Eviper01/MAX7000CPU-GEN2.5/Other/logo.dxf

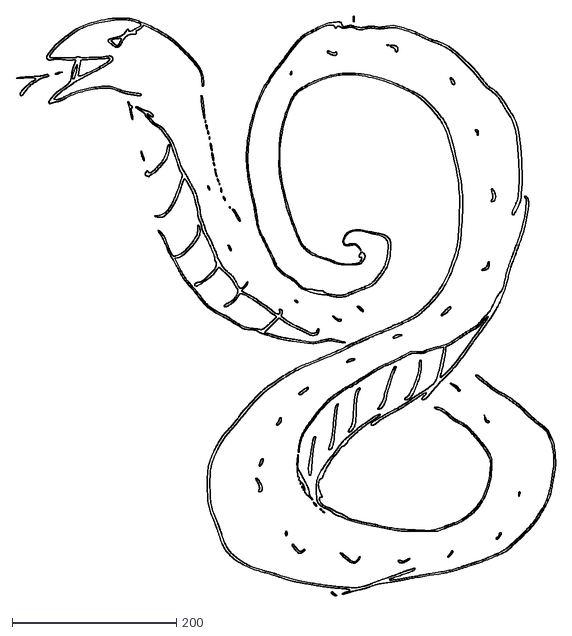
[picture p1: CAD file, 2022-04-16]
Other/logo.dxf
656.7 x 706.0
