Eviper01/MAX7000CPU-GEN2.5/SASM/test.txt

STC &LOOP
LDM RJB
STC 1
LDM R1
STC 2
LDM R2
&LOOP SUM R1 R2
LDM R1
LDM PORTC
SUM R1 R2
LDM R2
LDM PORTC
JMP
