Eviper01/MAX7000CPU-GEN2.5/(list of files, drawings)

Other design files:
KICAD/MAX7000CPU-Gen2_5.dsn
