Eviper01/MAX7000CPU-GEN2.5/KICAD/MAX7000CPU-Gen2_5.kicad_pcb

## KiCad design KICAD/MAX7000CPU-Gen2_5.kicad_pcb (2022-04-16)

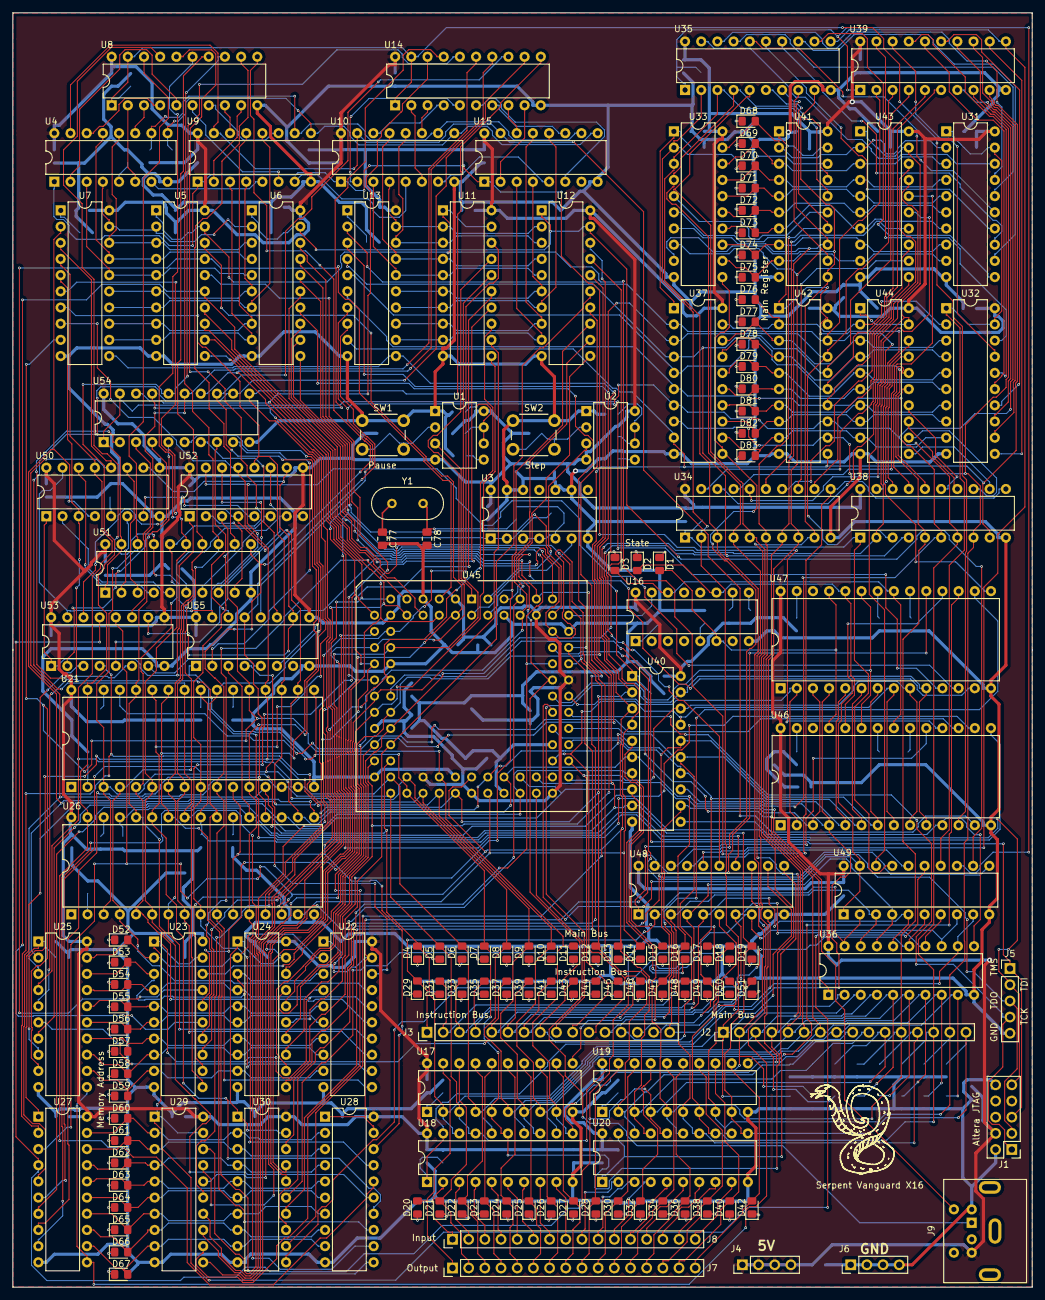
[picture p2: board MAX7000CPU-Gen2_5.kicad_pcb from above]

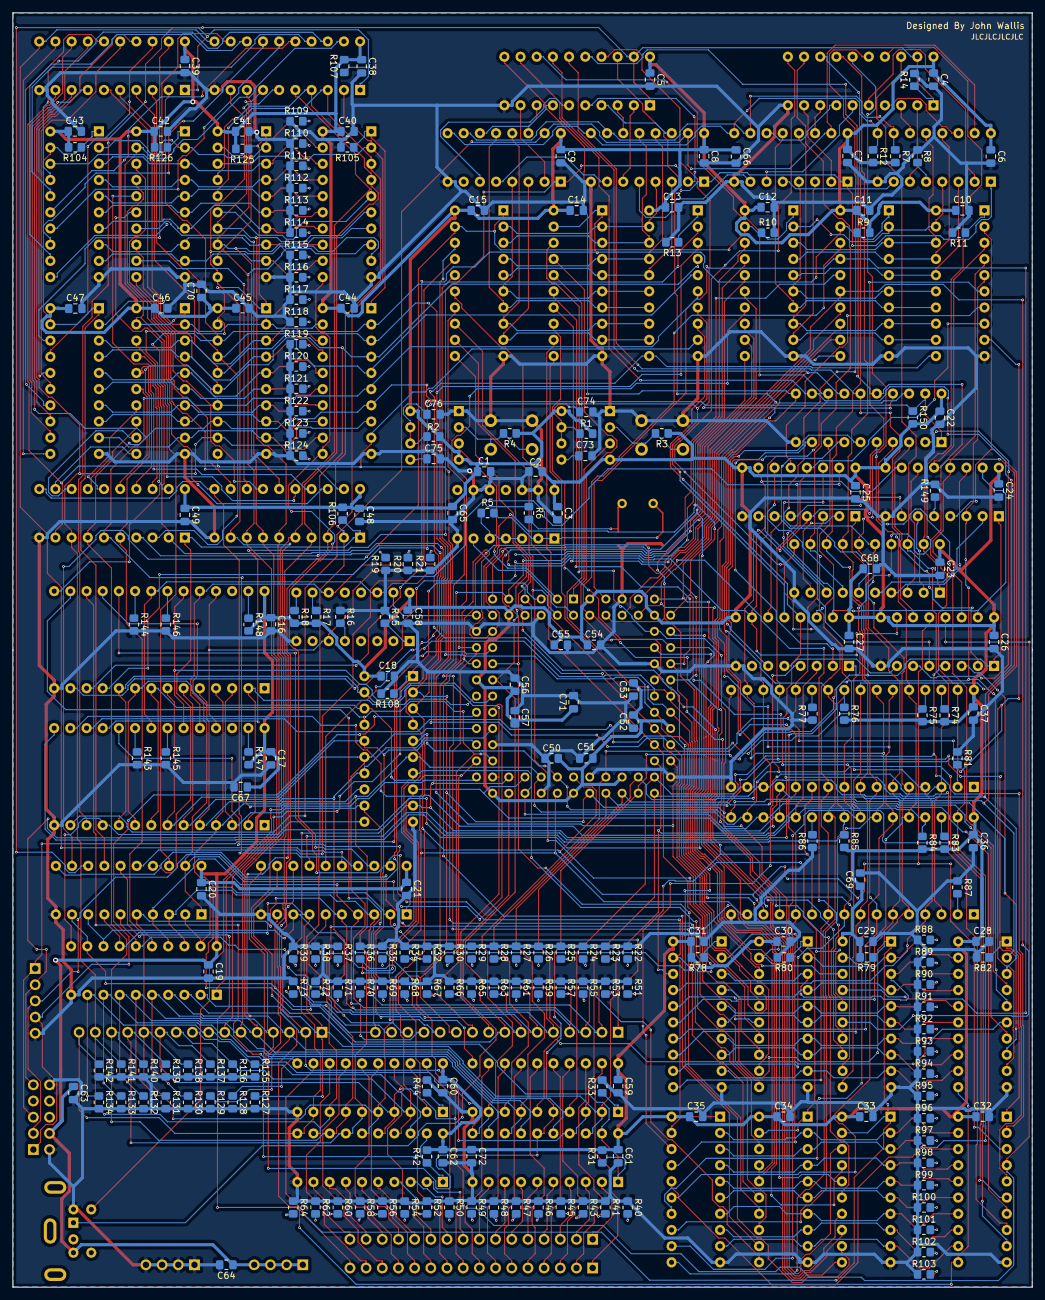
[picture p3: board MAX7000CPU-Gen2_5.kicad_pcb from below]

Board: 2 copper layers, 160.0 x 200.0 mm, 378 parts (226 on the bottom side), 398 nets.

Parts:
C1, C2, C3, C4, C5, C6, C7, C8, C9, C10, C11, C12, C13, C14, C15, C16, C17, C18, C19, C20, C21, C22, C23, C24, C25, C26, C27, C28, C29, C30, C31, C32, C33, C34, C35, C36, C37, C38, C39, C40, C41, C42, C43, C44, C45, C46, C47, C48, C49, C50, C51, C52, C53, C54, C55, C56, C57, C58, C59, C60, C61, C62, C63, C64, C74, C76: 100n; C_0805_2012Metric_Pad1.18x1.45mm_HandSolder
C65, C66, C67, C68, C69, C70, C71, C72: 10u; C_0805_2012Metric_Pad1.18x1.45mm_HandSolder
C73, C75: 10n; C_0805_2012Metric_Pad1.18x1.45mm_HandSolder
C77, C78: 33p; C_0805_2012Metric_Pad1.18x1.45mm_HandSolder
D1, D2, D3, D4, D5, D6, D7, D8, D9, D10, D11, D12, D13, D14, D15, D16, D17, D18, D19, D20, D21, D22, D23, D24, D25, D26, D27, D28, D29, D30, D31, D32, D33, D34, D35, D36, D37, D38, D39, D40, D41, D42, D43, D44, D45, D46, D47, D48, D49, D50, D51, D52, D53, D54, D55, D56, D57, D58, D59, D60, D61, D62, D63, D64, D65, D66, D67, D68, D69, D70, D71, D72, D73, D74, D75, D76, D77, D78, D79, D80, D81, D82, D83: LED; LED_0805_2012Metric_Pad1.15x1.40mm_HandSolder
J1: Conn_02x05_Odd_Even; PinHeader_2x05_P2.54mm_Vertical
J2, J3, J7, J8: Conn_01x16_Male; PinHeader_1x16_P2.54mm_Vertical
J4, J6: Conn_01x04_Male; PinHeader_1x04_P2.54mm_Vertical
J5: Conn_01x05_Male; PinHeader_1x05_P2.54mm_Vertical
J9: Mini-DIN-6; Connector_Mini-DIN_Female_6Pin_2rows
R1, R2, R5: 1M; R_0805_2012Metric_Pad1.20x1.40mm_HandSolder
R3, R4: 1K; R_0805_2012Metric_Pad1.20x1.40mm_HandSolder
R6: 4.7K; R_0805_2012Metric_Pad1.20x1.40mm_HandSolder
R7, R8, R9, R10, R11, R12, R13, R14, R15, R16, R17, R18, R31, R33, R42, R44, R74, R75, R76, R77, R78, R79, R80, R81, R82, R83, R84, R85, R86, R87, R104, R105, R106, R107, R108, R125, R126, R127, R128, R129, R130, R131, R132, R133, R134, R135, R136, R137, R138, R139, R140, R141, R142, R143, R144, R145, R146, R147, R148, R149, R150: 50K; R_0805_2012Metric_Pad1.20x1.40mm_HandSolder
R19, R20, R21, R22, R23, R24, R25, R26, R27, R28, R29, R30, R32, R34, R35, R36, R37, R38, R39, R40, R41, R43, R45, R46, R47, R48, R49, R50, R51, R52, R53, R54, R55, R56, R57, R58, R59, R60, R61, R62, R63, R64, R65, R66, R67, R68, R69, R70, R71, R72, R73, R88, R89, R90, R91, R92, R93, R94, R95, R96, R97, R98, R99, R100, R101, R102, R103, R109, R110, R111, R112, R113, R114, R115, R116, R117, R118, R119, R120, R121, R122, R123, R124: 330; R_0805_2012Metric_Pad1.20x1.40mm_HandSolder
SW1, SW2: SW_Push; SW_PUSH_6mm
U1, U2: NE555P; DIP-8_W7.62mm
U3: 74HC00; DIP-14_W7.62mm
U4, U9, U10, U15, U16, U50, U52, U53, U55: CD4029BEE4; DIP-16_W7.62mm
U5, U6, U8, U11, U12, U14, U18, U20, U22, U23, U24, U28, U29, U30, U31, U32, U41, U42, U43, U44, U48, U49, U51, U54: 74LS541; DIP-20_W7.62mm
U7, U13, U17, U19, U25, U27, U33, U34, U35, U36, U37, U38, U39, U40: 74LS574; DIP-20_W7.62mm
U21, U26: AS6C1008-55PCN; DIP-32_W15.24mm
U45: EPM7128slc84-15n; PLCC-84_THT-Socket
U46, U47: AT28C64B-15PU; DIP-28_W15.24mm
Y1: Crystal; Crystal_HC49-U_Vertical

Connections:
+5V: C1.1, C2.1, C3.1, C4.1, C5.1, C6.1, C7.1, C8.1, C9.1, C10.1, C11.1, C12.1, C13.1, C14.1, C15.1, C16.1, C17.1, C18.1, C19.1, C20.1, C21.1, C22.1, C23.1, C24.1, C25.1, C26.1, C27.1, C28.1, C29.1, C30.1, C31.1, C32.1, C33.1, C34.1, C35.1, C36.1, C37.1, C38.1, C39.1, C40.1, C41.1, C42.1, C43.1, C44.1, C45.1, C46.1, C47.1, C48.1, C49.1, C50.1, C51.1, C52.1, C53.1, C54.1, C55.1, C56.1, C57.1, C58.1, C59.1, C60.1, C61.1, C62.1, C63.1, C64.1, C65.1, C66.1, C67.1, C68.1, C69.1, C70.1, C71.1, C72.1, J1.4, J4.1, J4.2, J4.3, J4.4, J9.4, R1.1, R2.1, R3.1, R4.1, R7.2, R9.2, R12.2, R17.2, R18.2, R31.2, R42.2, R74.2, R75.2, R76.2, R78.2, R79.2, R83.2, R84.2, R85.2, R104.2, R106.2, R107.2, R125.2, R126.2, R147.2, R148.2, R150.2, U1.4, U1.8, U2.4, U2.8, U3.14, U4.16, U5.20, U6.20, U7.20, U8.20, U9.16, U10.16, U11.20, U12.20, U13.20, U14.20, U15.16, U16.16, U17.20, U18.20, U19.20, U20.20, U21.32, U22.20, U23.20, U24.20, U25.20, U26.32, U27.20, U28.20, U29.20, U30.20, U31.20, U32.20, U33.20, U34.20, U35.20, U36.20, U37.20, U38.20, U39.20, U40.20, U41.20, U42.20, U43.20, U44.20, U45.3, U45.13, U45.26, U45.38, U45.43, U45.53, U45.66, U45.78, U46.28, U47.28, U48.20, U49.20, U50.9, U50.16, U51.20, U52.9, U52.16, U53.9, U53.16, U54.20, U55.9, U55.16
/ALU/B0: D4.2, J2.1, R127.1, U7.2, U17.2, U18.18, U21.13, U25.2, U33.2, U34.2, U35.2, U36.2, U41.18, U45.31, U50.4
/ALU/B1: D5.2, J2.2, R128.1, U7.3, U17.3, U18.17, U21.14, U25.3, U33.3, U34.3, U35.3, U36.3, U41.17, U45.33, U50.12
/ALU/B2: D6.2, J2.3, R129.1, U7.4, U17.4, U18.16, U21.15, U25.4, U33.4, U34.4, U35.4, U36.4, U41.16, U45.34, U50.13
/ALU/B3: D7.2, J2.4, R130.1, U7.5, U17.5, U18.15, U21.17, U25.5, U33.5, U34.5, U35.5, U36.5, U41.15, U45.35, U50.3
/ALU/B4: D8.2, J2.5, R131.1, U7.6, U17.6, U18.14, U21.18, U25.6, U33.6, U34.6, U35.6, U36.6, U41.14, U45.36, U52.4
/ALU/B5: D9.2, J2.6, R132.1, U7.7, U17.7, U18.13, U21.19, U25.7, U33.7, U34.7, U35.7, U36.7, U41.13, U45.37, U52.12
/ALU/B6: D10.2, J2.7, R133.1, U7.8, U17.8, U18.12, U21.20, U25.8, U33.8, U34.8, U35.8, U36.8, U41.12, U45.39, U52.13
/ALU/B7: D11.2, J2.8, R134.1, U7.9, U17.9, U18.11, U21.21, U25.9, U33.9, U34.9, U35.9, U36.9, U41.11, U45.40, U52.3
/ALU/B8: D12.2, J2.9, R135.1, U13.2, U19.2, U20.18, U26.13, U27.2, U37.2, U38.2, U39.2, U40.2, U42.18, U45.41, U53.4
/ALU/B9: D13.2, J2.10, R136.1, U13.3, U19.3, U20.17, U26.14, U27.3, U37.3, U38.3, U39.3, U40.3, U42.17, U45.44, U53.12
/ALU/B10: D14.2, J2.11, R137.1, U13.4, U19.4, U20.16, U26.15, U27.4, U37.4, U38.4, U39.4, U40.4, U42.16, U45.45, U53.13
/ALU/B11: D15.2, J2.12, R138.1, U13.5, U19.5, U20.15, U26.17, U27.5, U37.5, U38.5, U39.5, U40.5, U42.15, U45.46, U53.3
/ALU/B12: D16.2, J2.13, R139.1, U13.6, U19.6, U20.14, U26.18, U27.6, U37.6, U38.6, U39.6, U40.6, U42.14, U45.48, U55.4
/ALU/B13: D17.2, J2.14, R140.1, U13.7, U19.7, U20.13, U26.19, U27.7, U37.7, U38.7, U39.7, U40.7, U42.13, U45.49, U55.12
/ALU/B14: D18.2, J2.15, R141.1, U13.8, U19.8, U20.12, U26.20, U27.8, U37.8, U38.8, U39.8, U40.8, U42.12, U45.50, U55.13
/ALU/B15: D19.2, J2.16, R142.1, U13.9, U19.9, U20.11, U26.21, U27.9, U37.9, U38.9, U39.9, U40.9, U42.11, U45.52, U55.3
/ALU/Ins0: D29.2, J3.1, U36.19, U48.2, U49.2
/ALU/Ins1: D31.2, J3.2, U36.18, U48.3, U49.3
/ALU/Ins2: D33.2, J3.3, U36.17, U48.4, U49.4
/ALU/Ins3: D35.2, J3.4, U36.16, U48.5, U49.5
/ALU/Ins4: D37.2, J3.5, U36.15, U48.6, U49.6
/ALU/Ins5: D39.2, J3.6, U36.14, U48.7, U49.7
/ALU/Ins6: D41.2, J3.7, U36.13, U48.8, U49.8
/ALU/Ins7: D43.2, J3.8, U36.12, U48.9, U49.9
/ALU/Ins8: D44.2, J3.9, U40.19, U45.55, U46.10, U47.10
/ALU/Ins9: D45.2, J3.10, U40.18, U45.56, U46.9, U47.9
/ALU/Ins10: D46.2, J3.11, U40.17, U45.57, U46.8, U47.8
/ALU/Ins11: D47.2, J3.12, U40.16, U45.58, U46.7, U47.7
/ALU/Ins12: D48.2, J3.13, U40.15, U45.60, U46.6, U47.6
/ALU/Ins13: D49.2, J3.14, U40.14, U45.61, U46.5, U47.5
/ALU/Ins14: D50.2, J3.15, U40.13, U46.4, U47.4
/ALU/Ins15: D51.2, J3.16, U40.12, U46.3, U47.3
/ALU/r_A0: U5.18, U23.18, U45.4
/ALU/r_A1: U5.17, U23.17, U45.5
/ALU/r_A2: U5.16, U23.16, U45.6
/ALU/r_A3: U5.15, U23.15, U45.8
/ALU/r_A4: U5.14, U23.14, U45.9
/ALU/r_A5: U5.13, U23.13, U45.10
/ALU/r_A6: U5.12, U23.12, U45.11
/ALU/r_A7: U5.11, U23.11, U45.12
/ALU/r_A8: U11.18, U29.18, U45.15
/ALU/r_A9: U11.17, U29.17, U45.16
/ALU/r_A10: U11.16, U29.16, U45.17
/ALU/r_A11: U11.15, U29.15, U45.18
/ALU/r_A12: U11.14, U29.14, U45.20
/ALU/r_A13: U11.13, U29.13, U45.21
/ALU/r_A14: U11.12, U29.12, U45.22
/ALU/r_A15: U11.11, U29.11, U45.24
/ALU/r_B0: U12.18, U24.18, U45.25
/ALU/r_B1: U12.17, U24.17, U45.27
/ALU/r_B2: U12.16, U24.16, U45.28
/ALU/r_B3: U12.15, U24.15, U45.29
/ALU/r_B4: U12.14, U24.14, U45.30
/ALU/r_B5: U12.13, U24.13, U45.84
/ALU/r_B6: U12.12, U24.12, U45.80
/ALU/r_B7: U12.11, U24.11, U45.79
/ALU/r_B8: U6.18, U30.18, U45.77
/ALU/r_B9: U6.17, U30.17, U45.76
/ALU/r_B10: U6.16, U30.16, U45.75
/ALU/r_B11: U6.15, U30.15, U45.73
/ALU/r_B12: U6.14, U30.14, U45.70
/ALU/r_B13: U6.13, U30.13, U45.69
/ALU/r_B14: U6.12, U30.12, U45.68
/ALU/r_B15: U6.11, U30.11, U45.67
/Counter Module/JB0: U4.4, U5.2, U6.2, U7.19
/Counter Module/JB1: U4.12, U5.3, U6.3, U7.18
/Counter Module/JB2: U4.13, U5.4, U6.4, U7.17
/Counter Module/JB3: U4.3, U5.5, U6.5, U7.16
/Counter Module/JB4: U5.6, U6.6, U7.15, U9.4
/Counter Module/JB5: U5.7, U6.7, U7.14, U9.12
/Counter Module/JB6: U5.8, U6.8, U7.13, U9.13
/Counter Module/JB7: U5.9, U6.9, U7.12, U9.3
/Counter Module/JB8: U10.4, U11.2, U12.2, U13.19
/Counter Module/JB9: U10.12, U11.3, U12.3, U13.18
/Counter Module/JB10: U10.13, U11.4, U12.4, U13.17
/Counter Module/JB11: U10.3, U11.5, U12.5, U13.16
/Counter Module/JB12: U11.6, U12.6, U13.15, U15.4
/Counter Module/JB13: U11.7, U12.7, U13.14, U15.12
/Counter Module/JB14: U11.8, U12.8, U13.13, U15.13
/Counter Module/JB15: U11.9, U12.9, U13.12, U15.3
/Counter Module/RA0: U8.18, U21.3, U22.18, U26.3, U51.18
/Counter Module/RA1: U8.17, U21.4, U22.17, U26.4, U51.17
/Counter Module/RA2: U8.16, U21.5, U22.16, U26.5, U51.16
/Counter Module/RA3: U8.15, U21.6, U22.15, U26.6, U51.15
/Counter Module/RA4: U8.14, U21.7, U22.14, U26.7, U51.14
/Counter Module/RA5: U8.13, U21.8, U22.13, U26.8, U51.13
/Counter Module/RA6: U8.12, U21.9, U22.12, U26.9, U51.12
/Counter Module/RA7: U8.11, U21.10, U22.11, U26.10, U51.11
/Counter Module/RA8: U14.18, U21.11, U26.11, U28.18, U54.18
/Counter Module/RA9: U14.17, U21.12, U26.12, U28.17, U54.17
/Counter Module/RA10: U14.16, U21.31, U26.31, U28.16, U54.16
/Counter Module/RA11: U14.15, U21.28, U26.28, U28.15, U54.15
/Counter Module/RA12: U14.14, U21.27, U26.27, U28.14, U54.14
/Counter Module/RA13: U14.13, U21.26, U26.26, U28.13, U54.13
/Counter Module/RA14: U14.12, U21.25, U26.25, U28.12, U54.12
/Counter Module/RA15: U14.11, U21.23, U26.23, U28.11, U54.11
/Counter Module/State0: D1.2, U16.6, U46.25, U47.25
/Counter Module/State1: D2.2, U16.11, U46.24, U47.24
/Counter Module/State2: D3.2, U16.14, U46.21, U47.21
/Interface/PI0: J8.1, U18.2
/Interface/PI1: J8.2, U18.3
/Interface/PI2: J8.3, U18.4
/Interface/PI3: J8.4, U18.5
/Interface/PI4: J8.5, U18.6
/Interface/PI5: J8.6, U18.7
/Interface/PI6: J8.7, U18.8
/Interface/PI7: J8.8, U18.9
/Interface/PI8: J8.9, U20.2
/Interface/PI9: J8.10, U20.3
/Interface/PI10: J8.11, U20.4
/Interface/PI11: J8.12, U20.5
/Interface/PI12: J8.13, U20.6
/Interface/PI13: J8.14, U20.7
/Interface/PI14: J8.15, U20.8
/Interface/PI15: J8.16, U20.9
/Interface/PO0: D20.2, J7.1, U17.19
/Interface/PO1: D21.2, J7.2, U17.18
/Interface/PO2: D22.2, J7.3, U17.17
/Interface/PO3: D23.2, J7.4, U17.16
/Interface/PO4: D24.2, J7.5, U17.15
/Interface/PO5: D25.2, J7.6, U17.14
/Interface/PO6: D26.2, J7.7, U17.13
/Interface/PO7: D27.2, J7.8, U17.12
/Interface/PO8: D28.2, J7.9, U19.19
/Interface/PO9: D30.2, J7.10, U19.18
/Interface/PO10: D32.2, J7.11, U19.17
/Interface/PO11: D34.2, J7.12, U19.16
/Interface/PO12: D36.2, J7.13, U19.15
/Interface/PO13: D38.2, J7.14, U19.14
/Interface/PO14: D40.2, J7.15, U19.13
/Interface/PO15: D42.2, J7.16, U19.12
/Memory/MA0: D52.2, U22.2, U23.2, U24.2, U25.19
/Memory/MA1: D53.2, U22.3, U23.3, U24.3, U25.18
/Memory/MA2: D54.2, U22.4, U23.4, U24.4, U25.17
/Memory/MA3: D55.2, U22.5, U23.5, U24.5, U25.16
/Memory/MA4: D56.2, U22.6, U23.6, U24.6, U25.15
/Memory/MA5: D57.2, U22.7, U23.7, U24.7, U25.14
/Memory/MA6: D58.2, U22.8, U23.8, U24.8, U25.13
/Memory/MA7: D59.2, U22.9, U23.9, U24.9, U25.12
/Memory/MA8: D60.2, U27.19, U28.2, U29.2, U30.2
/Memory/MA9: D61.2, U27.18, U28.3, U29.3, U30.3
/Memory/MA10: D62.2, U27.17, U28.4, U29.4, U30.4
/Memory/MA11: D63.2, U27.16, U28.5, U29.5, U30.5
/Memory/MA12: D64.2, U27.15, U28.6, U29.6, U30.6
/Memory/MA13: D65.2, U27.14, U28.7, U29.7, U30.7
/Memory/MA14: D66.2, U27.13, U28.8, U29.8, U30.8
/Memory/MA15: D67.2, U27.12, U28.9, U29.9, U30.9
/Registers/MR0: D68.2, U31.2, U33.19, U41.2, U43.2
/Registers/MR1: D69.2, U31.3, U33.18, U41.3, U43.3
/Registers/MR2: D70.2, U31.4, U33.17, U41.4, U43.4
/Registers/MR3: D71.2, U31.5, U33.16, U41.5, U43.5
/Registers/MR4: D72.2, U31.6, U33.15, U41.6, U43.6
/Registers/MR5: D73.2, U31.7, U33.14, U41.7, U43.7
/Registers/MR6: D74.2, U31.8, U33.13, U41.8, U43.8
/Registers/MR7: D75.2, U31.9, U33.12, U41.9, U43.9
/Registers/MR8: D76.2, U32.2, U37.19, U42.2, U44.2
/Registers/MR9: D77.2, U32.3, U37.18, U42.3, U44.3
/Registers/MR10: D78.2, U32.4, U37.17, U42.4, U44.4
/Registers/MR11: D79.2, U32.5, U37.16, U42.5, U44.5
/Registers/MR12: D80.2, U32.6, U37.15, U42.6, U44.6
/Registers/MR13: D81.2, U32.7, U37.14, U42.7, U44.7
/Registers/MR14: D82.2, U32.8, U37.13, U42.8, U44.8
/Registers/MR15: D83.2, U32.9, U37.12, U42.9, U44.9
/Registers/rA0: U34.19, U43.18
/Registers/rA1: U34.18, U43.17
/Registers/rA2: U34.17, U43.16
/Registers/rA3: U34.16, U43.15
/Registers/rA4: U34.15, U43.14
/Registers/rA5: U34.14, U43.13
/Registers/rA6: U34.13, U43.12
/Registers/rA7: U34.12, U43.11
/Registers/rA8: U38.19, U44.18
/Registers/rA9: U38.18, U44.17
/Registers/rA10: U38.17, U44.16
/Registers/rA11: U38.16, U44.15
/Registers/rA12: U38.15, U44.14
/Registers/rA13: U38.14, U44.13
/Registers/rA14: U38.13, U44.12
/Registers/rA15: U38.12, U44.11
/Registers/rB0: U31.18, U35.19
/Registers/rB1: U31.17, U35.18
/Registers/rB2: U31.16, U35.17
/Registers/rB3: U31.15, U35.16
/Registers/rB4: U31.14, U35.15
/Registers/rB5: U31.13, U35.14
/Registers/rB6: U31.12, U35.13
/Registers/rB7: U31.11, U35.12
/Registers/rB8: U32.18, U39.19
/Registers/rB9: U32.17, U39.18
/Registers/rB10: U32.16, U39.17
/Registers/rB11: U32.15, U39.16
/Registers/rB12: U32.14, U39.15
/Registers/rB13: U32.13, U39.14
/Registers/rB14: U32.12, U39.13
/Registers/rB15: U32.11, U39.12
ALU_Regs: U45.63, U47.18, U49.1, U49.19
CLK: U16.15, U45.74
CLK_Select: U1.3, U45.1
Count: U4.15, U9.15, U10.15, U15.15, U46.13
CounterOutControl: R14.1, U8.1, U8.19, U14.1, U14.19, U46.12
EqualFlag: U45.65, U46.23, U47.23
FastCLK: U3.6, U45.2
GND: C1.2, C2.2, C3.2, C4.2, C5.2, C6.2, C7.2, C8.2, C9.2, C10.2, C11.2, C12.2, C13.2, C14.2, C15.2, C16.2, C17.2, C18.2, C19.2, C20.2, C21.2, C22.2, C23.2, C24.2, C25.2, C26.2, C27.2, C28.2, C29.2, C30.2, C31.2, C32.2, C33.2, C34.2, C35.2, C36.2, C37.2, C38.2, C39.2, C40.2, C41.2, C42.2, C43.2, C44.2, C45.2, C46.2, C47.2, C48.2, C49.2, C50.2, C51.2, C52.2, C53.2, C54.2, C55.2, C56.2, C57.2, C58.2, C59.2, C60.2, C61.2, C62.2, C63.2, C64.2, C65.2, C66.2, C67.2, C68.2, C69.2, C70.2, C71.2, C72.2, C73.2, C74.2, C75.2, C76.2, C77.2, C78.2, J1.2, J1.10, J5.5, J6.1, J6.2, J6.3, J6.4, J9.3, R8.2, R10.2, R11.2, R13.2, R14.2, R15.2, R16.2, R19.1, R20.1, R21.1, R22.1, R23.1, R24.1, R25.1, R26.1, R27.1, R28.1, R29.1, R30.1, R32.1, R33.2, R34.1, R35.1, R36.1, R37.1, R38.1, R39.1, R40.1, R41.1, R43.1, R44.2, R45.1, R46.1, R47.1, R48.1, R49.1, R50.1, R51.1, R52.1, R53.1, R54.1, R55.1, R56.1, R57.1, R58.1, R59.1, R60.1, R61.1, R62.1, R63.1, R64.1, R65.1, R66.1, R67.1, R68.1, R69.1, R70.1, R71.1, R72.1, R73.1, R77.1, R80.2, R81.1, R82.2, R86.1, R87.1, R88.1, R89.1, R90.1, R91.1, R92.1, R93.1, R94.1, R95.1, R96.1, R97.1, R98.1, R99.1, R100.1, R101.1, R102.1, R103.1, R105.2, R108.2, R109.1, R110.1, R111.1, R112.1, R113.1, R114.1, R115.1, R116.1, R117.1, R118.1, R119.1, R120.1, R121.1, R122.1, R123.1, R124.1, R127.2, R128.2, R129.2, R130.2, R131.2, R132.2, R133.2, R134.2, R135.2, R136.2, R137.2, R138.2, R139.2, R140.2, R141.2, R142.2, R143.2, R144.2, R145.2, R146.2, R149.2, SW1.1, SW2.1, U1.1, U2.1, U3.7, U3.9, U3.10, U3.12, U3.13, U4.8, U5.10, U6.10, U7.10, U8.10, U9.8, U10.8, U11.10, U12.10, U13.10, U14.10, U15.8, U16.8, U17.10, U18.10, U19.10, U20.10, U21.16, U22.10, U23.10, U24.10, U25.10, U26.16, U27.10, U28.10, U29.10, U30.10, U31.10, U32.10, U33.10, U34.10, U35.10, U36.10, U37.10, U38.10, U39.10, U40.10, U41.10, U42.10, U43.10, U44.10, U45.7, U45.19, U45.32, U45.42, U45.47, U45.59, U45.72, U45.82, U46.14, U47.14, U48.10, U49.10, U50.8, U51.10, U52.8, U53.8, U54.10, U55.8
I2CCLK: J9.5, U45.54
I2CData: J9.1, U45.51
InsRegControl: U36.11, U40.11, U46.11
JumpBufferAOutput: R9.1, U5.1, U5.19, U11.1, U11.19, U49.16
JumpBufferBOutput: R10.1, U6.1, U6.19, U12.1, U12.19, U49.12
JumpEnable: U4.1, U9.1, U10.1, U15.1, U46.18
JumpRegLoad: U7.11, U13.11, U48.15
MainAOutput: R126.1, U43.1, U43.19, U44.1, U44.19, U49.18
MainBOutput: R104.1, U31.1, U31.19, U32.1, U32.19, U49.14
MainRegOutputControl: R125.1, U41.1, U41.19, U42.1, U42.19, U47.15
MainRegReadControl: U33.11, U37.11, U48.18
MemAddrAOutput: R79.1, U23.1, U23.19, U29.1, U29.19, U49.15
MemAddrBOutput: R80.1, U24.1, U24.19, U30.1, U30.19, U49.11
MemOutEnable: R76.1, R85.1, U21.24, U26.24, U46.15
MemWriteControlH: R84.1, U26.29, U46.16
MemWriteControlL: R75.1, U21.29, U46.17
unnamed: C73.1, U1.5
unnamed: C74.1, R1.2, U1.6, U1.7
unnamed: C75.1, U2.5
unnamed: C76.1, R2.2, U2.6, U2.7
unnamed: C77.1, R5.2, U3.1, U3.2, Y1.1
unnamed: C78.1, R6.2, Y1.2
unnamed: D1.1, R19.2
unnamed: D2.1, R20.2
unnamed: D3.1, R21.2
unnamed: D4.1, R22.2
unnamed: D5.1, R23.2
unnamed: D6.1, R24.2
unnamed: D7.1, R25.2
unnamed: D8.1, R26.2
unnamed: D9.1, R27.2
unnamed: D10.1, R28.2
unnamed: D11.1, R29.2
unnamed: D12.1, R30.2
unnamed: D13.1, R32.2
unnamed: D14.1, R34.2
unnamed: D15.1, R35.2
unnamed: D16.1, R36.2
unnamed: D17.1, R37.2
unnamed: D18.1, R38.2
unnamed: D19.1, R39.2
unnamed: D20.1, R40.2
unnamed: D21.1, R41.2
unnamed: D22.1, R43.2
unnamed: D23.1, R45.2
unnamed: D24.1, R46.2
unnamed: D25.1, R47.2
unnamed: D26.1, R48.2
unnamed: D27.1, R49.2
unnamed: D28.1, R50.2
unnamed: D29.1, R51.2
unnamed: D30.1, R52.2
unnamed: D31.1, R53.2
unnamed: D32.1, R54.2
unnamed: D33.1, R55.2
unnamed: D34.1, R56.2
unnamed: D35.1, R57.2
unnamed: D36.1, R58.2
unnamed: D37.1, R59.2
unnamed: D38.1, R60.2
unnamed: D39.1, R61.2
unnamed: D40.1, R62.2
unnamed: D41.1, R63.2
unnamed: D42.1, R64.2
unnamed: D43.1, R65.2
unnamed: D44.1, R66.2
unnamed: D45.1, R67.2
unnamed: D46.1, R68.2
unnamed: D47.1, R69.2
unnamed: D48.1, R70.2
unnamed: D49.1, R71.2
unnamed: D50.1, R72.2
unnamed: D51.1, R73.2
unnamed: D52.1, R88.2
unnamed: D53.1, R89.2
unnamed: D54.1, R90.2
unnamed: D55.1, R91.2
unnamed: D56.1, R92.2
unnamed: D57.1, R93.2
unnamed: D58.1, R94.2
unnamed: D59.1, R95.2
unnamed: D60.1, R96.2
unnamed: D61.1, R97.2
unnamed: D62.1, R98.2
unnamed: D63.1, R99.2
unnamed: D64.1, R100.2
unnamed: D65.1, R101.2
unnamed: D66.1, R102.2
unnamed: D67.1, R103.2
unnamed: D68.1, R109.2
unnamed: D69.1, R110.2
unnamed: D70.1, R111.2
unnamed: D71.1, R112.2
unnamed: D72.1, R113.2
unnamed: D73.1, R114.2
unnamed: D74.1, R115.2
unnamed: D75.1, R116.2
unnamed: D76.1, R117.2
unnamed: D77.1, R118.2
unnamed: D78.1, R119.2
unnamed: D79.1, R120.2
unnamed: D80.1, R121.2
unnamed: D81.1, R122.2
unnamed: D82.1, R123.2
unnamed: D83.1, R124.2
unnamed: R3.2, SW1.2, U1.2
unnamed: R4.2, SW2.2, U2.2
unnamed: R5.1, R6.1, U3.3, U3.4, U3.5
unnamed: R7.1, U4.10, U9.10, U10.10, U15.10
unnamed: R8.1, U4.5
unnamed: R11.1, U7.1
unnamed: R12.1, U4.9, U9.9, U10.9, U15.9
unnamed: R13.1, U13.1
unnamed: R15.1, U16.1
unnamed: R16.1, U16.5
unnamed: R17.1, U16.10
unnamed: R18.1, U16.9
unnamed: R33.1, U17.1
unnamed: R44.1, U19.1
unnamed: R74.1, U21.30
unnamed: R77.2, U21.22
unnamed: R81.2, U21.2
unnamed: R82.1, U25.1, U27.1
unnamed: R83.1, U26.30
unnamed: R86.2, U26.22
unnamed: R87.2, U26.2
unnamed: R105.1, U33.1, U37.1
unnamed: R143.1, U46.20
unnamed: R144.1, U47.20
unnamed: R145.1, U46.22
unnamed: R146.1, U47.22
unnamed: R147.1, U46.27
unnamed: R148.1, U47.27
unnamed: R149.1, U50.5
unnamed: U4.2, U8.5
unnamed: U4.6, U8.2
unnamed: U4.7, U9.5
unnamed: U4.11, U8.3
unnamed: U4.14, U8.4
unnamed: U8.6, U9.6
unnamed: U8.7, U9.11
unnamed: U8.8, U9.14
unnamed: U8.9, U9.2
unnamed: U10.2, U14.5
unnamed: U9.7, U10.5
unnamed: U10.6, U14.2
unnamed: U10.7, U15.5
unnamed: U10.11, U14.3
unnamed: U10.14, U14.4
unnamed: U14.6, U15.6
unnamed: U14.7, U15.11
unnamed: U14.8, U15.14
unnamed: U14.9, U15.2
unnamed: U50.2, U51.5
unnamed: U50.6, U51.2
unnamed: U50.7, U52.5
unnamed: U50.11, U51.3
unnamed: U50.14, U51.4
unnamed: U51.6, U52.6
unnamed: U51.7, U52.11
unnamed: U51.8, U52.14
unnamed: U51.9, U52.2
unnamed: U52.7, U53.5
unnamed: U53.2, U54.5
unnamed: U53.6, U54.2
unnamed: U53.7, U55.5
unnamed: U53.11, U54.3
unnamed: U53.14, U54.4
unnamed: U54.6, U55.6
unnamed: U54.7, U55.11
unnamed: U54.8, U55.14
unnamed: U54.9, U55.2
OverflowFlag: U45.64, U46.2, U47.2
PortALatch: U17.11, U47.16
PortBLatch: U19.11, U47.17
PortCRead: R31.1, U18.1, U18.19, U48.12
PortDRead: R42.1, U20.1, U20.19, U48.11
ProgramEnable: R108.1, U36.1, U40.1, U45.81
R1Output: R106.1, U34.1, U38.1, U49.17
R1ReadControl: U34.11, U38.11, U48.17
R2Output: R107.1, U35.1, U39.1, U49.13
R2ReadControl: U35.11, U39.11, U48.16
RAM_Addr_Enable: R78.1, U22.1, U22.19, U28.1, U28.19, U46.19
Ram_Addr_Read: U25.11, U27.11, U48.13
RegRead: U47.19, U48.1, U48.19
StackCount: U47.12, U50.15, U52.15, U53.15, U55.15
StackCountDirection: U47.13, U50.10, U52.10, U53.10, U55.10
StackJump: U48.14, U50.1, U52.1, U53.1, U55.1
StackOutControl: R150.1, U47.11, U51.1, U51.19, U54.1, U54.19
TCK: J1.1, J5.4, U45.62
TDI: J1.9, J5.2, U45.14
TDO: J1.3, J5.3, U45.71
TMS: J1.5, J5.1, U45.23
UserCLK: U2.3, U45.83
