Eviper01/MAX7000CPU-GEN2.5/(commit log)

2022-04-16 Commit Setup (No Libraries)
    [ALU.sch, Clock_Module.sch, Counter_Module.sch, Instruction_Decoder.sch, Interface.sch, LEDs.sch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]
2022-04-17 ALC draft
    [ALU.sch]
2022-04-18 BOM update
2022-04-30 Microcode and hardware issues
    [X16 Microcode.xlsx]
2022-06-27 A few changes to notes
    [ALU.kicad_sch, Clock_Module.kicad_sch, Counter_Module.kicad_sch, Instruction_Decoder.kicad_sch, Interface.kicad_sch, MAX7000CPU-Gen2_5.kicad_sch, Memory.kicad_sch, Registers.kicad_sch]
2022-06-28 Microcode Hexfile Generator
    [X16 Microcode.csv, X16 Microcode.xlsx]
2022-06-30 ALC heavy modifications
    [X16 Microcode.csv, X16 Microcode.xlsx]
